Tino-97/work-guardian-cps-dicita-maker-faire/drone/maps/1_collective_safety_check/map_apriltag_markers.png

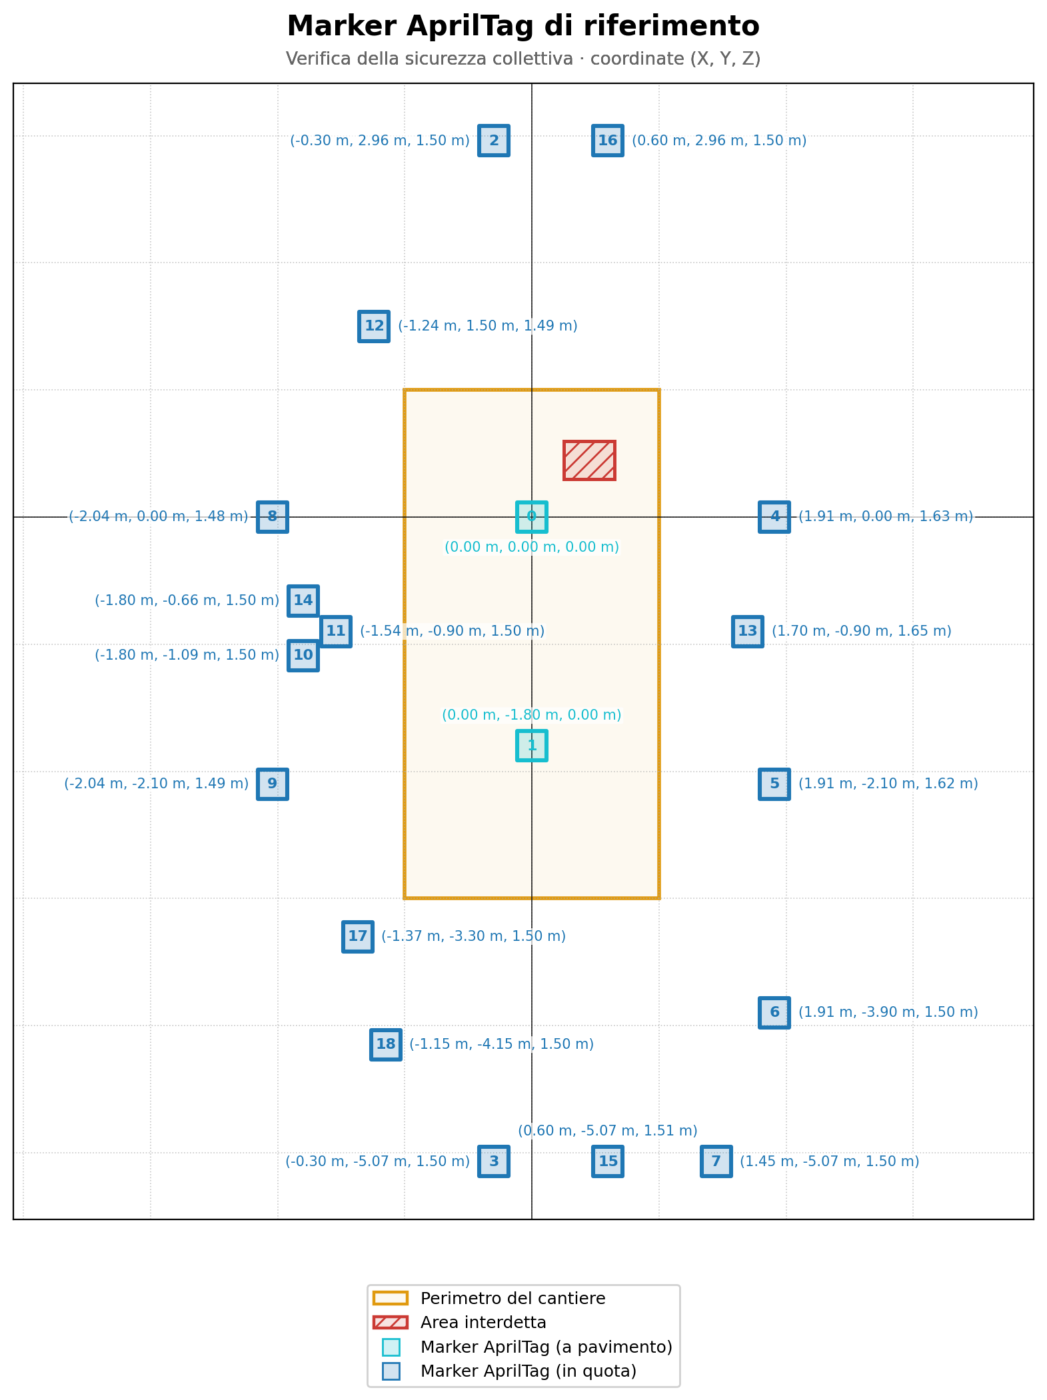
drone/maps/1_collective_safety_check/map_apriltag_markers.png
