Tino-97/work-guardian-cps-dicita-maker-faire/drone/maps/1_collective_safety_check/map_waypoint_path.png

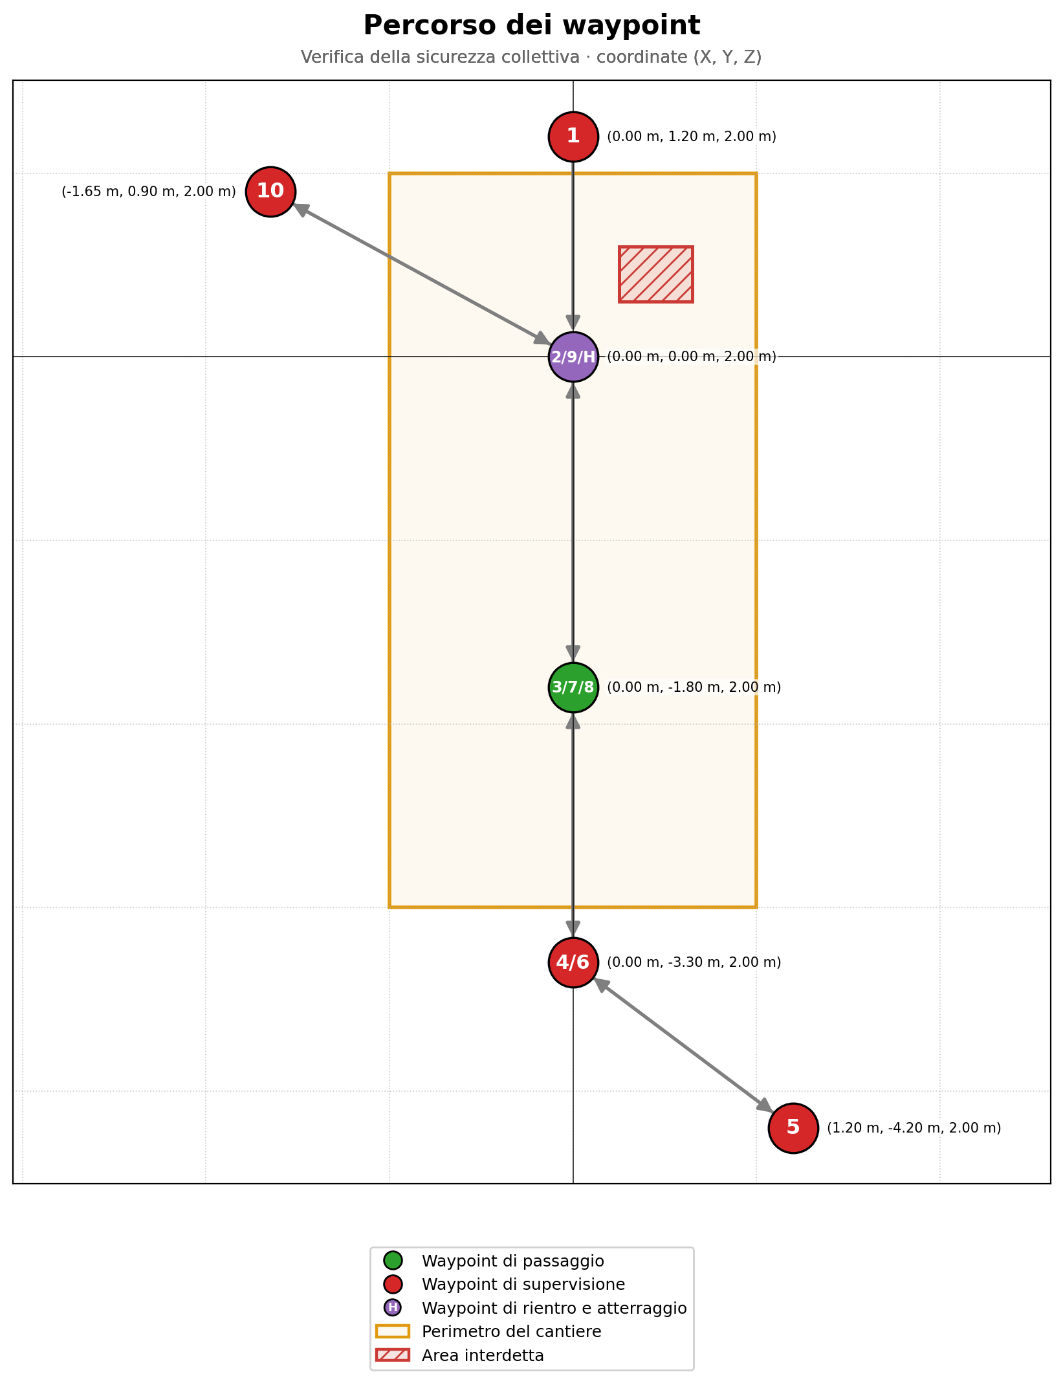
drone/maps/1_collective_safety_check/map_waypoint_path.png
