Tino-97/work-guardian-cps-dicita-maker-faire/drone/maps/2_operator_safety_check/map_path_and_markers.png

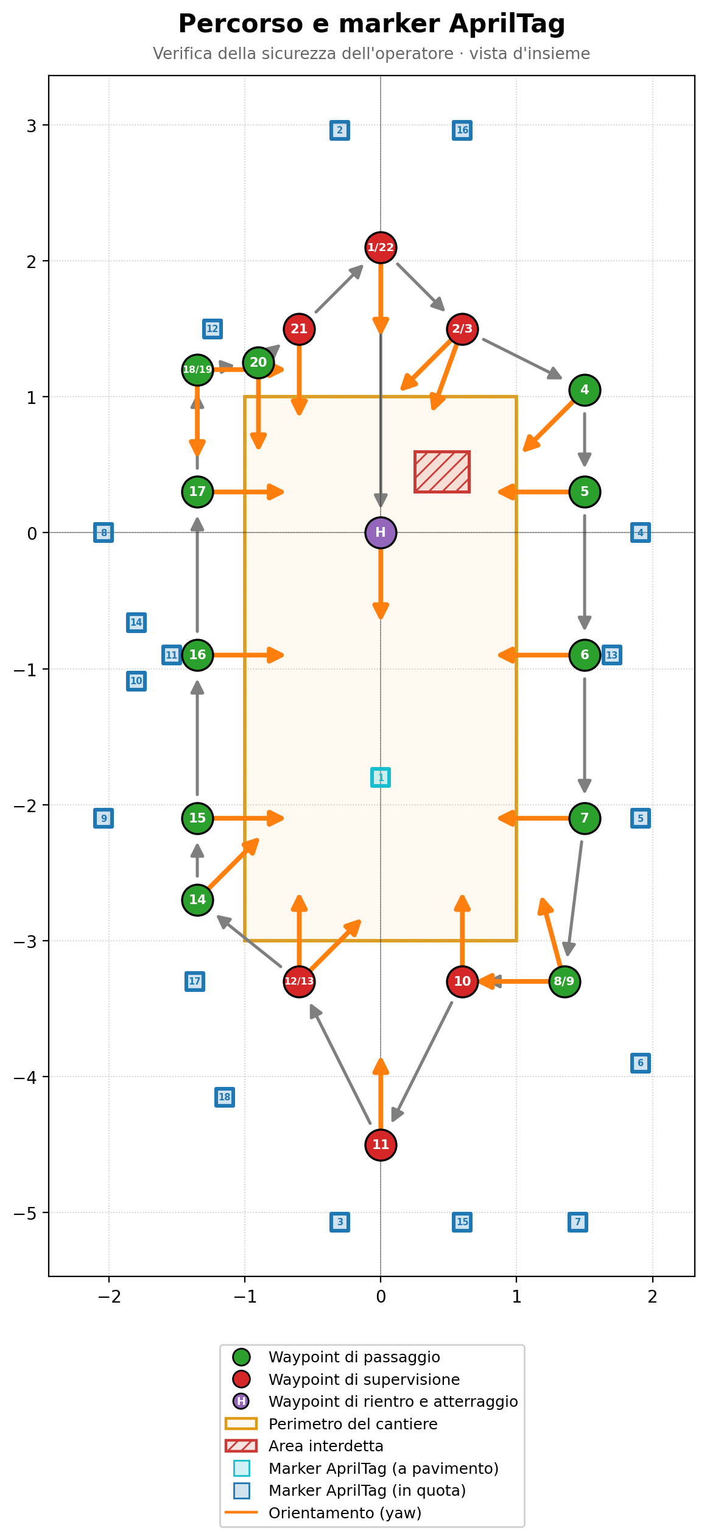
drone/maps/2_operator_safety_check/map_path_and_markers.png
