Tino-97/work-guardian-cps-dicita-maker-faire/wearable/schematics/schema_fisico.png

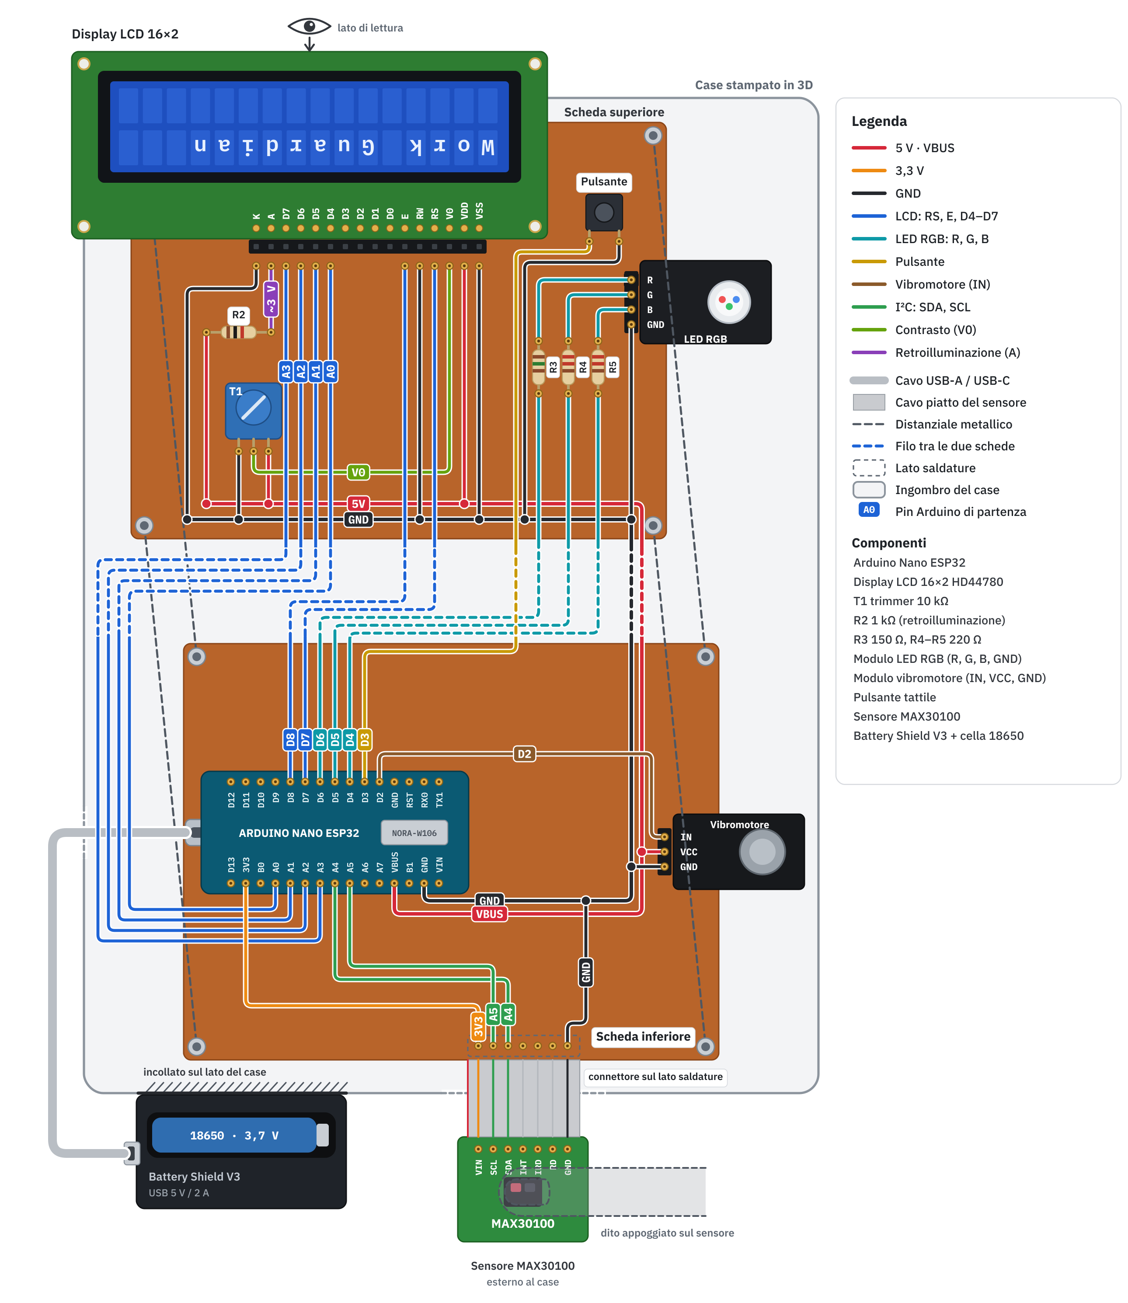
wearable/schematics/schema_fisico.png
