Tino-97/work-guardian-cps-dicita-maker-faire/wearable/schematics/tabella_riferimento.png

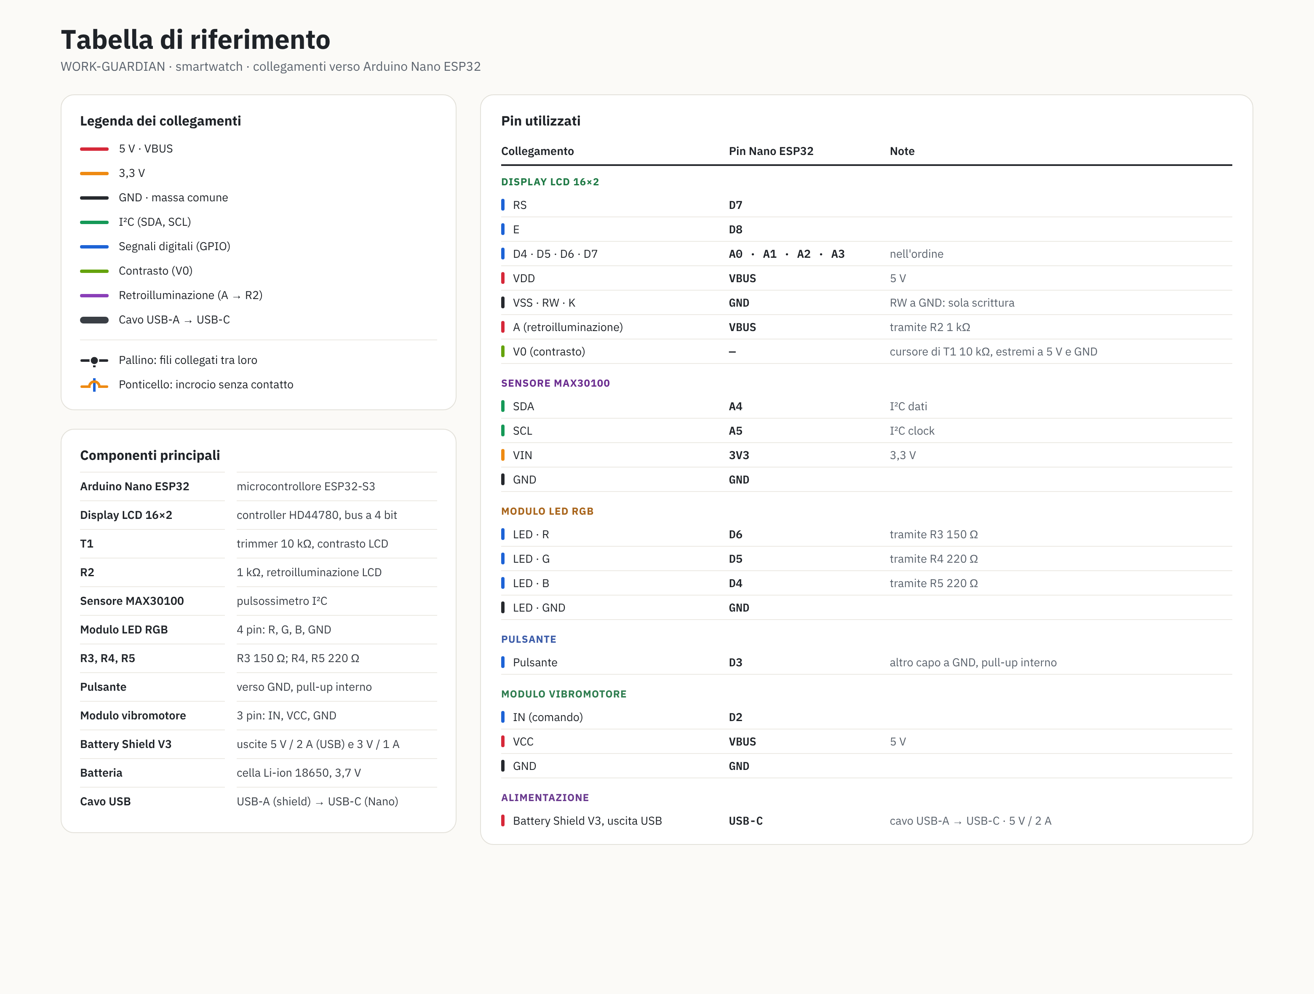
wearable/schematics/tabella_riferimento.png
