Tino-97/work-guardian-cps-dicita-maker-faire/wearable/case/smartwatch_case_3d.stl

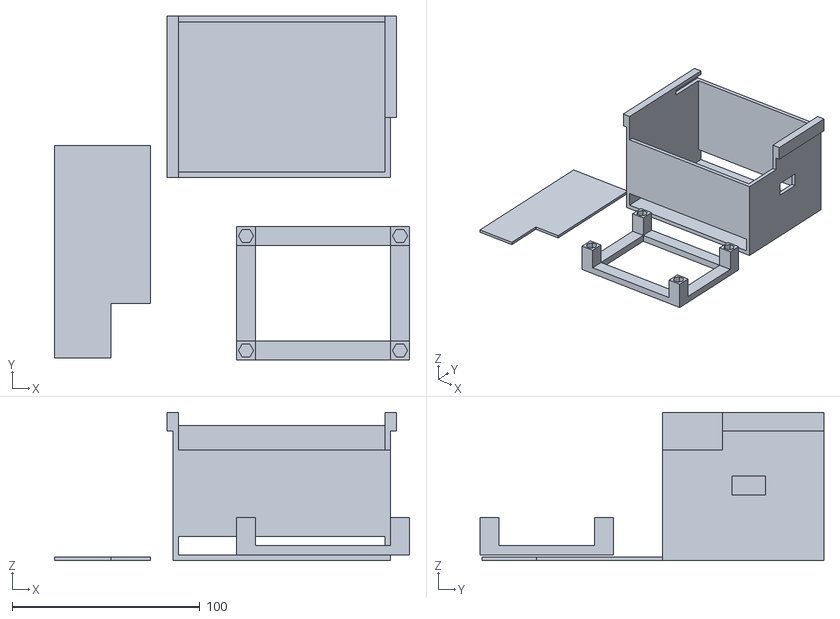
[picture p7: CAD file, 2026-10-18]
wearable/case/smartwatch_case_3d.stl
189.0 x 183.0 x 79.0
