Tino-97/work-guardian-cps-dicita-maker-faire/vision/models/collective_protection/results.csv

epoch | time | train/box_loss | train/cls_loss | train/dfl_loss | metrics/precision(B) | metrics/recall(B) | metrics/mAP50(B) | metrics/mAP50-95(B) | val/box_loss | val/cls_loss | val/dfl_loss | lr/pg0 | lr/pg1 | lr/pg2
1 | 40,1529 | 1,01217 | 6,09402 | 0,02218 | 0,37097 | 0,16667 | 0,20596 | 0,09178 | 0,98010 | 5,92597 | 0,02631 | 0,000060000 | 0,000060000 | 0,000060000
2 | 44,0658 | 1,05973 | 5,70845 | 0,02453 | 0,06080 | 0,33333 | 0,20866 | 0,13357 | 0,37038 | 4,95419 | 0,01062 | 0,000137228 | 0,000137228 | 0,000137228
3 | 47,1036 | 0,64837 | 3,73863 | 0,01327 | 0,72937 | 0,45874 | 0,54851 | 0,50684 | 0,43551 | 2,87250 | 0,01389 | 0,000211288 | 0,000211288 | 0,000211288
4 | 50,2010 | 0,59908 | 2,95925 | 0,01205 | 0,56251 | 0,22918 | 0,41977 | 0,33592 | 0,82095 | 2,78058 | 0,02698 | 0,000282180 | 0,000282180 | 0,000282180
5 | 53,4406 | 0,84011 | 2,14295 | 0,01955 | 0,94160 | 0,66667 | 0,80726 | 0,66844 | 0,68702 | 2,10346 | 0,02317 | 0,000349904 | 0,000349904 | 0,000349904
6 | 56,4926 | 0,65241 | 1,64243 | 0,01358 | 0,82641 | 0,79873 | 0,78855 | 0,65324 | 0,75747 | 2,03059 | 0,02664 | 0,000414460 | 0,000414460 | 0,000414460
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
