Tino-97/work-guardian-cps-dicita-maker-faire/vision/models/person_fall/results.csv

epoch | time | train/box_loss | train/cls_loss | train/dfl_loss | metrics/precision(B) | metrics/recall(B) | metrics/mAP50(B) | metrics/mAP50-95(B) | val/box_loss | val/cls_loss | val/dfl_loss | lr/pg0 | lr/pg1 | lr/pg2
1 | 155,967 | 1,44823 | 2,40665 | 0,01668 | 0,63741 | 0,54403 | 0,58970 | 0,29268 | 1,65508 | 1,54054 | 0,02926 | 0,0005540840 | 0,0005540840 | 0,0005540840
2 | 287,340 | 1,62894 | 1,70306 | 0,01961 | 0,66362 | 0,57019 | 0,60446 | 0,29540 | 1,77424 | 1,56337 | 0,03155 | 0,0010960200 | 0,0010960200 | 0,0010960200
3 | 415,417 | 1,66327 | 1,68360 | 0,02035 | 0,67330 | 0,56404 | 0,61491 | 0,30265 | 1,75738 | 1,49780 | 0,03065 | 0,0016242000 | 0,0016242000 | 0,0016242000
4 | 543,736 | 1,65371 | 1,64491 | 0,02033 | 0,66091 | 0,60876 | 0,65000 | 0,32647 | 1,66757 | 1,42724 | 0,02813 | 0,0016051100 | 0,0016051100 | 0,0016051100
5 | 671,898 | 1,61589 | 1,58105 | 0,01950 | 0,70409 | 0,56772 | 0,63378 | 0,30852 | 1,73546 | 1,40346 | 0,02976 | 0,0015844800 | 0,0015844800 | 0,0015844800
6 | 800,212 | 1,58387 | 1,49362 | 0,01884 | 0,70187 | 0,59321 | 0,65952 | 0,33986 | 1,66821 | 1,38920 | 0,02872 | 0,0015638500 | 0,0015638500 | 0,0015638500
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
