Tino-97/work-guardian-cps-dicita-maker-faire/vision/models/personal_protection/results.csv

epoch | time | train/box_loss | train/cls_loss | train/dfl_loss | metrics/precision(B) | metrics/recall(B) | metrics/mAP50(B) | metrics/mAP50-95(B) | val/box_loss | val/cls_loss | val/dfl_loss | lr/pg0 | lr/pg1 | lr/pg2 | lr/pg3 | lr/pg4 | lr/pg5 | lr/pg6 | lr/pg7
1 | 374,986 | 1,63531 | 2,61650 | 0,01118 | 0,70218 | 0,62721 | 0,67347 | 0,35654 | 1,56817 | 1,22121 | 0,01179 | 0,00998553 | 0,00332851 | 0,00998553 | 0,00332851 | 0,00998553 | 0,00332851 | 0,00998553 | 0,00332851
2 | 693,120 | 1,53510 | 1,58587 | 0,01036 | 0,70789 | 0,66316 | 0,71206 | 0,39838 | 1,54071 | 1,14302 | 0,01177 | 0,01991960 | 0,00663986 | 0,01991960 | 0,00663986 | 0,01991960 | 0,00663986 | 0,01991960 | 0,00663986
3 | 989,285 | 1,57196 | 1,59103 | 0,01075 | 0,67551 | 0,61783 | 0,65872 | 0,34039 | 1,65078 | 1,27790 | 0,01316 | 0,02978760 | 0,00992921 | 0,02978760 | 0,00992921 | 0,02978760 | 0,00992921 | 0,02978760 | 0,00992921
4 | 1278,340 | 1,59612 | 1,64243 | 0,01092 | 0,69253 | 0,66059 | 0,69807 | 0,37984 | 1,57385 | 1,14796 | 0,01221 | 0,02970300 | 0,00990100 | 0,02970300 | 0,00990100 | 0,02970300 | 0,00990100 | 0,02970300 | 0,00990100
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
