Tino-97/work-guardian-cps-dicita-maker-faire/vision/models/restricted_areas/results.csv

epoch | time | train/box_loss | train/cls_loss | train/dfl_loss | metrics/precision(B) | metrics/recall(B) | metrics/mAP50(B) | metrics/mAP50-95(B) | val/box_loss | val/cls_loss | val/dfl_loss | lr/pg0 | lr/pg1 | lr/pg2
1 | 18,5409 | 0,83690 | 7,06148 | 0,00633 | 0,03817 | 0,20000 | 0,04045 | 0,01714 | 0,67866 | 6,69759 | 0,01776 | 0,00004000 | 0,00004000 | 0,00004000
2 | 21,5771 | 0,71030 | 6,07544 | 0,00538 | 0,04487 | 0,20000 | 0,09041 | 0,03537 | 0,64410 | 5,92243 | 0,01538 | 0,00009670 | 0,00009670 | 0,00009670
3 | 23,4311 | 0,68883 | 5,63478 | 0,00479 | 0,56369 | 0,52737 | 0,45734 | 0,45642 | 0,29631 | 3,84342 | 0,00491 | 0,00014944 | 0,00014944 | 0,00014944
4 | 25,4032 | 0,54745 | 3,43054 | 0,00324 | 0,65781 | 0,77342 | 0,62203 | 0,59389 | 0,39206 | 2,11737 | 0,00659 | 0,00019822 | 0,00019822 | 0,00019822
5 | 27,2810 | 0,62374 | 2,87166 | 0,00343 | 0,97641 | 0,40000 | 0,58111 | 0,56259 | 0,45552 | 1,89243 | 0,00916 | 0,00024304 | 0,00024304 | 0,00024304
6 | 29,1203 | 0,55951 | 2,42523 | 0,00452 | 0,74657 | 0,59178 | 0,69262 | 0,67232 | 0,38862 | 1,76199 | 0,00702 | 0,00028390 | 0,00028390 | 0,00028390
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
