Tino-97/work-guardian-cps-dicita-maker-faire/drone/maps/1_verifica_sicurezza_collettiva/mappa_percorso_e_marker.png

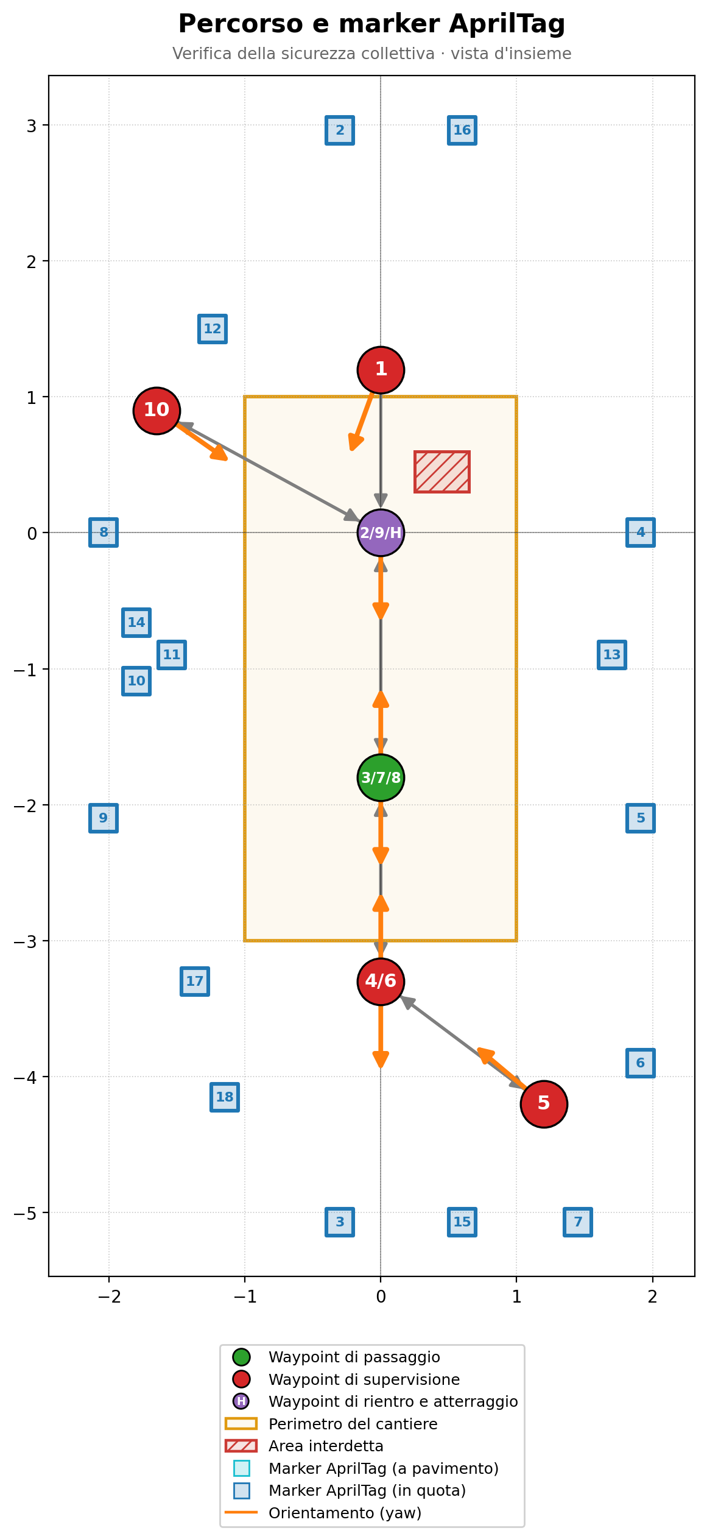
drone/maps/1_verifica_sicurezza_collettiva/mappa_percorso_e_marker.png
