Tino-97/work-guardian-cps-dicita-maker-faire/drone/maps/2_verifica_sicurezza_operatore/mappa_percorso_waypoint.png

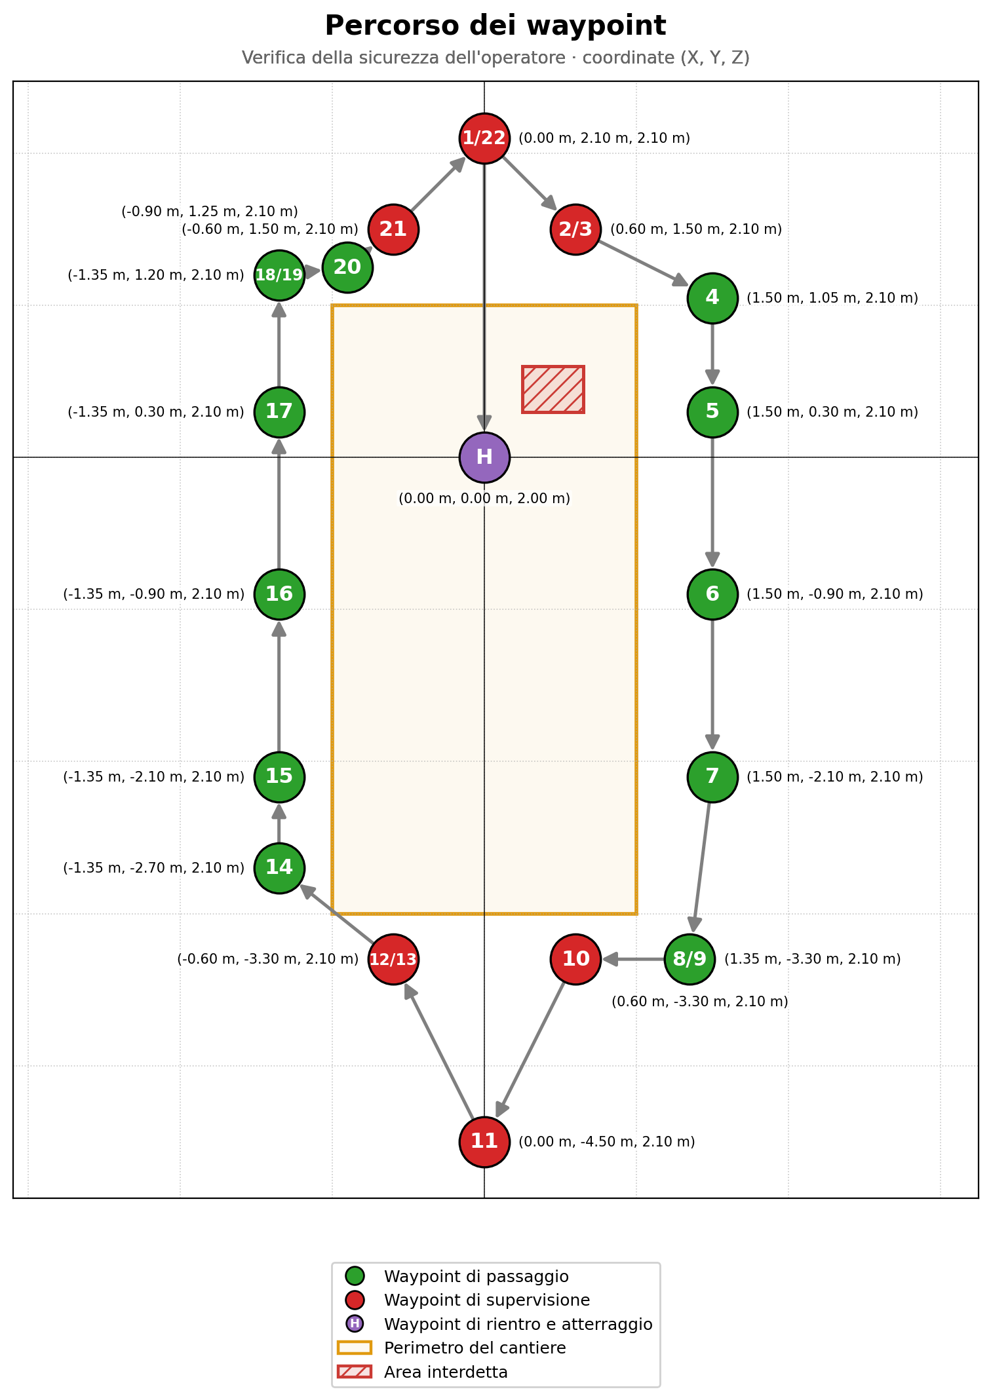
drone/maps/2_verifica_sicurezza_operatore/mappa_percorso_waypoint.png
